WilliamWilson-1/H745_OSC-GEN/assets/branding/initui-source.jpg

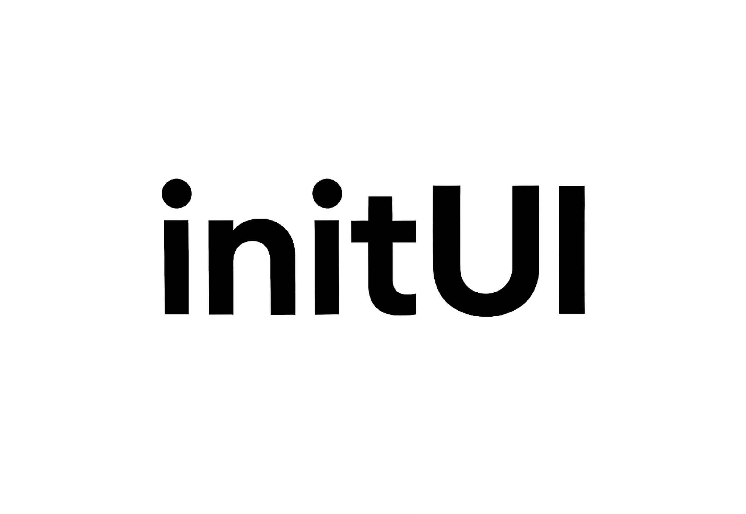
assets/branding/initui-source.jpg
