WilliamWilson-1/H745_OSC-GEN/docs/VALIDATION.md

# 固件验证记录（2026-09-15）

## v3.2 About / 主题增量（已刷写）

- 首页新增 About；显示原始 initUI 标志、William Wilson / Vida David / Dkkk、v3.2。
- 首页副标题改为 `Based on STM32H7`；About 顶栏不再显示 OSC / GEN。
- Graphite / Midnight / Ivory 三套主题覆盖四页，保留到复位；不更改仪器状态和输出，固定硬件调色板避免直接重着色当前扫描帧。
- H745 CM7、CM4、F103 三目标 Debug / Release 构建通过。CM7 Release：Flash 105,728 字节、DTCM 8,840 字节；原显存与 DMA 内存分区不变。
- 主机回归通过：四页 1,536,000 个按钮坐标；三套主题 × 四页渲染；主要文字配色对至少 4.5:1；重复切换、非法主题、调色板及待显示帧不变；已有缓冲、MDMA、拨钮、时基/粗微调、SINGLE/HOLD 与 99,951 个 DAC 频率设置测试。
- 已人工检查真实 C 渲染器生成的三种 About、首页、暖白示波器及发生器截图，无文字遮挡。截图波形是测试输入，不是设备实测。
- 已使用 ST-Link `002C00383331511434333834` 刷写 H745 CM4/CM7 Release，两核均读回校验成功并复位。F103 源码和通信协议未改变，本次未重复刷写 F103。
- 启动后 Hot Plug 只读检查：显示完成数从 366 增至 582，采集完成 583 帧，ADC/启动错误、FIFO 欠载、LTDC/MDMA 错误及超出消隐计数均为 0；最长复制 1053 us，预算 1422 us。最后读取为首页、DAC 关闭。这是短时启动检查，不代替物理触摸、主题切换和长期显示压力实测。
- 本次 CM7 Release ELF SHA-256：`C27B95792EB8364FF887B54878387B9B7242DB692BEABEDE504721AFC72600CB`；CM4 为 `F555630E9C6998F93C6CE584BCED17A4AAF6CEC866A00A100FD938B86CEDEEDF`。
- 以下分隔线之后的哈希、运行计数与实机结论保留为前一版记录。

---

## 本次功能

- 首页删除 01/02 编号；示波器卡片显示同一份真实 ADC trace，RUN 更新、HOLD 保持，无帧不伪造波形。
- 示波器右侧 Coarse/Fine 控制旋钮步进；标准档位与约 10% 微调相互切换，触发/垂直位置为 50 mV/10 mV。
- 同时包含此前的 2～20 us/div 快速时基、100 kHz 发生器设置上限、自适应 DAC 点数、仅右侧拨钮点击/拖动，以及消隐期 MDMA 刷新方案。
- 修复启动保护问题：本仓库 HAL 的 `HAL_RCCEx_GetPeriphCLKFreq()` 不支持 LTDC，改用 `HAL_RCCEx_GetPLL3ClockFreq()` 的 PLL3R 输出计算消隐预算。

## 构建与主机测试

H745 CM7、CM4、F103 的 Debug / Release 均构建通过。

`tools/preview_ui.py` 使用真实 C 源码和模拟 HAL 检查：

- 三页全部 1,152,000 个坐标的按钮命中、不重叠/越界及 48 px 最小高度。
- 连续/分段缓冲逐像素一致、边界保护、动效中断、减弱动效、时间回绕。
- 首页随输入改变，HOLD 不随时间自行改变，无数据提示，以及粗微调选中状态。
- 拨钮点击/拖动、中点保留、取消、页面离开、仅松手提交通断。
- 1000 次模拟消隐 MDMA 复制、延迟中断、重复提交及错误计数。
- 12 个标准时基、快速档 40/100/200/400 个真实点、双边沿、SINGLE、HOLD 旧帧失效。
- 微调中间值与标准档位的方向衔接、上下限、复位以及 10/50 mV 步进。
- 全部 99,951 个 50～100000 Hz 整数频率设置不超过 DAC 1 MHz 更新限制，100 kHz 名义定时分频准确，改表前停止 DMA。

可选 Windows AddressSanitizer 出现运行库拦截兼容警告，不将其列为完整通过的检查；普通主机测试断言全部通过。

## 刷写

使用明确的 ST-Link 序列号选择目标，Release 固件均写入并读回校验成功：

| 目标 | 实际识别 | 固件地址 |
| --- | --- | --- |
| H745 CM7 | NUCLEO-H745ZI-Q，设备 ID 0x450，Rev V，2 MiB Flash | 0x08000000 |
| H745 CM4 | 同一 H745 双核器件 | 0x08100000 |
| F103 | 设备 ID 0x410，64 KiB Flash，Cortex-M3 | 0x08000000 |

F103 继续采用实际板卡所需的晶振配置，未擅自改成 NUCLEO-F103RB 的 MCO 配置。PCB 接线表仍以用户指定的官方开发板排针为设计目标，见其适用条件说明。

已刷写 ELF 的 SHA-256（构建路径/工具链变化可能改变 ELF 的哈希）：

| 文件 | SHA-256 |
| --- | --- |
| NUCLEO_1_CM7.elf | `35B2F724A5A3B99DAB19A507CB84922F2F4626F9B6661DE67EE0AE8752467121` |
| NUCLEO_1_CM4.elf | `F555630E9C6998F93C6CE584BCED17A4AAF6CEC866A00A100FD938B86CEDEEDF` |
| stm32f103_hmi.elf | `EE93EC6496AD8E5174622ECBDA8CE07FF004FF7B1A429B071C98B3EEB79EBA76` |

## 实机运行检查

复位启动后，首页默认 RUN 可连续采集和提交画面。通过调试接口向 H745 触摸接收队列注入正常格式的测试消息，检查真实主循环处理路径；旋钮测试使用 TIM3 计数变化，不调用被测调整函数来绕过输入分发。

1. 进入示波器、连续双指缩放至 2 us/div，状态报告配置采样率 2,000,000 Hz。
2. 点击 Fine 后增加一个编码器计数，时基从 2 变为 3 us/div。
3. 点击 Coarse 后增加一个编码器计数，时基从 3 变为 5 us/div。
4. 点击 RUN/HOLD 再返回 Home：`running=0`、`frame_valid=1`，首页保持已有帧。两次独立读数之间采集和刷新计数保持不变。

在首页、快速时基连续采集与上述操作后读取的累计状态：

| 指标 | 结果 |
| --- | --- |
| 完成采集帧数 | 19,130 |
| 提交 / 完成显示帧数 | 5,109 / 5,109 |
| ADC 错误 / 启动失败 | 0 / 0 |
| LTDC FIFO 欠载 / 传输错误 | 0 / 0 |
| MDMA 错误 / 超出消隐次数 | 0 / 0 |
| 最近 / 最大整帧复制耗时 | 1053 / 1055 us |
| 消隐预算 | 1422 us |
| 发生器输出 | OFF，测试期间未开启 |

结束后复位回默认首页、500 us/div、粗调，DAC 输出关闭。

## 未覆盖的条件

这些结果不代替手指在实际屏幕上的手感确认，也不证明物理触摸 I2C/UART 全链路已完成所有异常测试。测试消息注入绕过了 F103 与触摸传感器。

本次未主动给外部电路开启 DAC 输出，因此未测量 100 kHz 输出的失真、满幅建立时间、实际频率精度，也未验证 ADC/DAC 同时工作时的总线压力。2 MS/s 为定时器配置值，未用外部基准独立校准。模拟输入带宽、接线负载、长时间运行、极端触摸压力和用户肉眼观察闪烁仍需要进一步实测。
