WilliamWilson-1/H745_OSC-GEN/CM7/Core/Src/main.c

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
/* Includes ------------------------------------------------------------------*/
#include "main.h"

/* USER CODE BEGIN Includes */
#include <math.h>  // 提供 sin() 函数支持
#include <stdlib.h> // 提供 abs() 函数支持
#include <stdio.h>
#include <stdarg.h>
#include <string.h>
#include "graph.h"
#include "display.h"
#include "generate.h"
#include "oscilloscope.h"
/* USER CODE END Includes */

/* USER CODE BEGIN PD */

/* DUAL_CORE_BOOT_SYNC_SEQUENCE: Define for dual core boot synchronization    */
/*                             demonstration code based on hardware semaphore */
/* This define is present in both CM7/CM4 projects                            */
/* To comment when developping/debugging on a single core                     */
// #define DUAL_CORE_BOOT_SYNC_SEQUENCE
//
// #if defined(DUAL_CORE_BOOT_SYNC_SEQUENCE)
// #ifndef HSEM_ID_0
// #define HSEM_ID_0 (0U) /* HW semaphore 0*/
// #endif
// #endif /* DUAL_CORE_BOOT_SYNC_SEQUENCE */

/* USER CODE END PD */


ADC_HandleTypeDef hadc1;
DMA_HandleTypeDef hdma_adc1;

DAC_HandleTypeDef hdac1;
DMA_HandleTypeDef hdma_dac1_ch2;

LTDC_HandleTypeDef hltdc;

TIM_HandleTypeDef htim3;
TIM_HandleTypeDef htim6;
TIM_HandleTypeDef htim2;

UART_HandleTypeDef huart1;

void SystemClock_Config(void);
static void MPU_Config(void);
static void MX_GPIO_Init(void);
static void MX_DMA_Init(void);
static void MX_ADC1_Init(void);
static void MX_LTDC_Init(void);
static void MX_TIM2_Init(void);
static void MX_TIM3_Init(void);
static void MX_USART1_UART_Init(void);
static void MX_DAC1_Init(void);
static void MX_TIM6_Init(void);
/* USER CODE BEGIN 0 */

// 💥 封装一个硬件同步中心：把 0~3.3V 转化为 0~2047 写入底层
void Sync_Hardware_WaveGen(void) {
    float hw_amp = (wg_amp / 3.3f) * 2047.0f;
    DAC_WaveGen_Configure(wg_wave, hw_amp, (uint32_t)wg_freq);
}

// 双指手势引擎内部变量
static uint16_t last_pinch_dist_x = 0;
static uint16_t last_pinch_dist_y = 0;
static uint8_t is_pinching = 0;

// 极客专属：格式化串口发送函数
void UART_SendToF103(const char *format, ...) {
    char tx_buf[64];
    va_list args;
    va_start(args, format);
    vsnprintf(tx_buf, sizeof(tx_buf), format, args);
    va_end(args);
    HAL_UART_Transmit(&huart1, (uint8_t*)tx_buf, strlen(tx_buf), 100);
}

// 触摸与重绘全局标志
volatile uint8_t global_needs_redraw = 0;
uint8_t h7_rx_byte;
static uint8_t touch_rx[256];
static volatile uint16_t touch_head, touch_tail;
static volatile uint8_t touch_overflow;
static void Poll_Touch_Input(void);

static void Reset_Current_Mode(void) {
    UI_OutputTouchCancel(HAL_GetTick());
    if (current_sys_state != SYS_OSC && current_sys_state != SYS_GEN) return;
    if (current_sys_state == SYS_OSC) {
        Oscilloscope_ResetControls();
        current_ctrl = CTRL_TIMEBASE;
    } else if (current_sys_state == SYS_GEN) {
        wg_freq = 1000.0f;
        wg_amp = 3.3f;
        wg_wave = WAVE_SINE;
        wg_ctrl = 0U;
        wg_enabled = 0U;
        DAC_WaveGen_SetEnabled(0U);
        Sync_Hardware_WaveGen();
        UART_SendToF103("F:1000\n");
        UART_SendToF103("A:3.3\n");
    }
    UI_NotifyReset(HAL_GetTick());
    global_needs_redraw = 1U;
}

// =========================================================
// 核心：带有“防抖与差分拦截”的触摸碰撞引擎
// =========================================================
void Process_Touch_Interaction(uint16_t x, uint16_t y) {
    UI_OutputTouchCancel(HAL_GetTick());
    global_needs_redraw = 1U;
    is_pinching = 0;
    UiAction action = UI_HitTest(current_sys_state, x, y);
    if (action == UI_NONE) return;
    UI_NotifyTouch(action, HAL_GetTick());
    switch (action) {
    case UI_HOME:
        /* Keep RUN live on Home; HOLD/SINGLE state remains authoritative. */
        current_sys_state = SYS_MAIN_MENU;
        UART_SendToF103("I:\n");
        break;
    case UI_OSC:
        main_menu_sel = 0;
        current_sys_state = SYS_OSC;
        break;
    case UI_GEN:
        main_menu_sel = 1;
        current_sys_state = SYS_GEN;
        UART_SendToF103("F:%d\n", (int)wg_freq);
        break;
    case UI_TIME: current_ctrl = CTRL_TIMEBASE; break;
    case UI_VOLTS: current_ctrl = CTRL_VOLTS_DIV; break;
    case UI_TRIGGER: current_ctrl = CTRL_TRIGGER_LEVEL; break;
    case UI_POSITION: current_ctrl = CTRL_VERTICAL_POS; break;
    case UI_RUN: Oscilloscope_ToggleRun(); break;
    case UI_SLOPE:
        Oscilloscope_SetTriggerSlope(Oscilloscope_GetState()->trigger_slope ==
            OSC_TRIGGER_RISING ? OSC_TRIGGER_FALLING : OSC_TRIGGER_RISING);
        break;
    case UI_SINGLE: Oscilloscope_Single(); break;
    case UI_COARSE: Oscilloscope_SetFineAdjustment(false); break;
    case UI_FINE: Oscilloscope_SetFineAdjustment(true); break;
    case UI_SINE: case UI_SQUARE: case UI_TRIANGLE:
        wg_wave = action == UI_SINE ? WAVE_SINE :
                  action == UI_SQUARE ? WAVE_SQUARE : WAVE_TRIANGLE;
        Sync_Hardware_WaveGen();
        break;
    case UI_OUTPUT:
        UI_OutputTouchDown(x, y, HAL_GetTick());
        break;
    case UI_FREQUENCY: wg_ctrl = 0U; break;
    case UI_AMPLITUDE: wg_ctrl = 1U; break;
    case UI_MOTION: UI_ToggleMotion(); break;
    case UI_ABOUT: current_sys_state = SYS_ABOUT; break;
    case UI_THEME_DARK: UI_SelectTheme(UI_THEME_GRAPHITE); break;
    case UI_THEME_BLUE: UI_SelectTheme(UI_THEME_MIDNIGHT); break;
    case UI_THEME_LIGHT: UI_SelectTheme(UI_THEME_IVORY); break;
    default: break;
    }
    global_needs_redraw = 1U;
}


// =========================================================
// 双指操作支持
// =========================================================


void Process_Pinch_Gesture(uint16_t x1, uint16_t y1, uint16_t x2, uint16_t y2) {
    // 只有在示波器模式下才允许缩放波形
    if (current_sys_state != SYS_OSC) return;

    // 计算当前双指在 X 轴和 Y 轴上的绝对距离
    uint16_t dist_x = abs((int)x1 - (int)x2);
    uint16_t dist_y = abs((int)y1 - (int)y2);

    if (!is_pinching) {
        // 第一帧双指按下，只记录初始距离，不触发形变
        last_pinch_dist_x = dist_x;
        last_pinch_dist_y = dist_y;
        is_pinching = 1;
        return;
    }

    // 计算相对于上一帧的位移增量 (这就是虚拟旋转编码器的 diff！)
    int16_t diff_x = (int16_t)dist_x - (int16_t)last_pinch_dist_x;
    int16_t diff_y = (int16_t)dist_y - (int16_t)last_pinch_dist_y;

    // 更新距离历史
    last_pinch_dist_x = dist_x;
    last_pinch_dist_y = dist_y;

    uint8_t state_changed = 0;

    // 💥 轴向手势分离逻辑
    // 判断用户的意图是水平捏合（调时基/频率）还是垂直捏合（调幅值）

    if (abs(diff_x) > abs(diff_y) && abs(diff_x) > 2) {
        // 阈值设为 2 防止手抖抖动
        // 水平捏合：切换采样时基。

        // 双指拉开：减小 time/div，让波形沿水平方向放大；捏合则缩小。
        Oscilloscope_AdjustTimebase(diff_x > 0 ? -1 : 1);
        state_changed = 1;
    }
    else if (abs(diff_y) > abs(diff_x) && abs(diff_y) > 2) {
        // 垂直捏合：切换垂直 V/div 档位。

        // 双指拉开 (diff_y > 0)，幅值变大；捏合变小
        Oscilloscope_AdjustVoltsPerDiv(diff_y > 0 ? -1 : 1);
        state_changed = 1;
    }

    if (state_changed) {
        global_needs_redraw = 1;
    }
}


/* USER CODE END 0 */

/**
  * @brief  The application entry point.
  * @retval int
  */
int main(void)
{

/* USER CODE BEGIN Boot_Mode_Sequence_0 */
#if defined(DUAL_CORE_BOOT_SYNC_SEQUENCE)
  int32_t timeout;
#endif /* DUAL_CORE_BOOT_SYNC_SEQUENCE */
/* USER CODE END Boot_Mode_Sequence_0 */

  /* MPU Configuration--------------------------------------------------------*/
  MPU_Config();

/* USER CODE BEGIN Boot_Mode_Sequence_1 */
#if defined(DUAL_CORE_BOOT_SYNC_SEQUENCE)
  /* Wait until CPU2 boots and enters in stop mode or timeout*/
  timeout = 0xFFFF;
  while((__HAL_RCC_GET_FLAG(RCC_FLAG_D2CKRDY) != RESET) && (timeout-- > 0));
  if ( timeout < 0 )
  {
  Error_Handler();
  }
#endif /* DUAL_CORE_BOOT_SYNC_SEQUENCE */
/* USER CODE END Boot_Mode_Sequence_1 */
  /* MCU Configuration--------------------------------------------------------*/

  /* Reset of all peripherals, Initializes the Flash interface and the Systick. */
  HAL_Init();

  /* Configure the system clock */
  SystemClock_Config();
/* USER CODE BEGIN Boot_Mode_Sequence_2 */
#if defined(DUAL_CORE_BOOT_SYNC_SEQUENCE)
/* When system initialization is finished, Cortex-M7 will release Cortex-M4 by means of
HSEM notification */
/*HW semaphore Clock enable*/
__HAL_RCC_HSEM_CLK_ENABLE();
/*Take HSEM */
HAL_HSEM_FastTake(HSEM_ID_0);
/*Release HSEM in order to notify the CPU2(CM4)*/
HAL_HSEM_Release(HSEM_ID_0,0);
/* wait until CPU2 wakes up from stop mode */
timeout = 0xFFFF;
while((__HAL_RCC_GET_FLAG(RCC_FLAG_D2CKRDY) == RESET) && (timeout-- > 0));
if ( timeout < 0 )
{
Error_Handler();
}
#endif /* DUAL_CORE_BOOT_SYNC_SEQUENCE */
/* USER CODE END Boot_Mode_Sequence_2 */

  /* Initialize all configured peripherals */
  MX_GPIO_Init();
  MX_DMA_Init();
  MX_ADC1_Init();
  MX_LTDC_Init();
  MX_TIM2_Init();
  MX_TIM3_Init();
  MX_USART1_UART_Init();
  MX_DAC1_Init();
  MX_TIM6_Init();
  /* USER CODE BEGIN 2 */

    UART_SendToF103("I:\n");

    // 装载默认波形参数；输出保持关闭，进入 GEN 后由 OUTPUT 按钮开启。
    Sync_Hardware_WaveGen();
    DAC_WaveGen_Init();

    UI_InitPalette();

    // 2. 启动编码器硬件解码！(TIM3)
    HAL_TIM_Encoder_Start(&htim3, TIM_CHANNEL_ALL);

    if (Oscilloscope_Init() != HAL_OK) {
        Error_Handler();
    }

    // Prepare a complete first frame before lighting the backlight.
    Display_Init();
    HAL_GPIO_WritePin(GPIOA, GPIO_PIN_7, GPIO_PIN_SET);


  /* USER CODE END 2 */

  /* Infinite loop */
  /* USER CODE BEGIN WHILE */

  // 别忘了在进入主循环前，开启串口接收中断，准备接收 F103 传来的触摸和手势数据
  HAL_UART_Receive_IT(&huart1, &h7_rx_byte, 1);

  int16_t last_encoder_cnt = (int16_t)__HAL_TIM_GET_COUNTER(&htim3);

  // Keep the initial ADC capture running for the Home live preview.
  Play_Cyber_Boot_Sequence();
  global_needs_redraw = 1U;

  while (1)
  {
      Poll_Touch_Input();
      // =========================================================
      // 编码器按键 (PE1)：无短按/长按复用，松开后只执行一次复位。
      // =========================================================
      static uint8_t encoder_btn_last = 1;
      static uint32_t btn_press_time = 0;

      uint8_t encoder_btn_now = HAL_GPIO_ReadPin(GPIOE, GPIO_PIN_1);

      // 只要处于低电平，就锁定旋钮防误触
      uint8_t is_button_pressing = (encoder_btn_now == GPIO_PIN_RESET);

      if (encoder_btn_last == 1 && encoder_btn_now == 0) {
          btn_press_time = HAL_GetTick();
      }

      if (encoder_btn_last == 0 && encoder_btn_now == 1) {
          if (HAL_GetTick() - btn_press_time >= 20U) {
              Reset_Current_Mode();
          }
      }

      encoder_btn_last = encoder_btn_now;

      // =========================================================
      // 唯一保留的物理输入：旋转编码器 (专职精细调参)
      // =========================================================
      int16_t current_cnt = (int16_t)__HAL_TIM_GET_COUNTER(&htim3);
      if (current_cnt != last_encoder_cnt) {
          int16_t diff = current_cnt - last_encoder_cnt;
          last_encoder_cnt = current_cnt;

          // 💥 只有在按键没被按下时，才允许响应旋转！(硬件与软件双重防误触)
          if (!is_button_pressing) {
              if (current_sys_state == SYS_OSC) {
                  UART_SendToF103("I:\n"); // 打断 F103 跑马灯
                  int16_t step = diff > 0 ? 1 : -1;
                  bool fine = Oscilloscope_GetState()->fine_adjustment;
                  switch (current_ctrl) {
                      case CTRL_TIMEBASE:
                          if (fine) Oscilloscope_AdjustTimebaseFine(step);
                          else Oscilloscope_AdjustTimebase(step);
                          break;
                      case CTRL_VOLTS_DIV:
                          if (fine) Oscilloscope_AdjustVoltsPerDivFine(step);
                          else Oscilloscope_AdjustVoltsPerDiv(step);
                          break;
                      case CTRL_TRIGGER_LEVEL:
                          if (fine) Oscilloscope_AdjustTriggerFine(-step);
                          else Oscilloscope_AdjustTrigger(-step);
                          break;
                      case CTRL_VERTICAL_POS:
                          if (fine) Oscilloscope_AdjustVerticalPositionFine(-step);
                          else Oscilloscope_AdjustVerticalPosition(-step);
                          break;
                  }
                  global_needs_redraw = 1;
              }
              else if (current_sys_state == SYS_GEN) {
                  if (wg_ctrl == 0) {
                      float step;

                      // 💥 核心逻辑：根据当前频率所在的区间，动态分配旋钮步长
                      if (wg_freq >= 10000.0f) {
                          step = 500.0f; // 大于等于 10k 时，步进 1kHz
                      } else if (wg_freq >= 1000.0f) {
                          step = 50.0f;  // 大于等于 1k 且小于 10k 时，步进 0.1kHz (100Hz)
                      } else {
                          step = 5.0f;    // 小于 1k 时，精细步进 5Hz
                      }

                      // 应用动态步长 (注意这里保留了你原来的 -= 逻辑，如果旋钮方向反了改成 += 即可)
                      wg_freq -= diff * step;

                      // 硬件物理极限防呆保护
                      if(wg_freq < 50.0f) wg_freq = 50.0f;
                      if(wg_freq > 100000.0f) wg_freq = 100000.0f;

                      UART_SendToF103("F:%d\n", (int)wg_freq); // 同步给 F103 VFD 屏幕
                  } else {
                      wg_amp -= diff * 0.05f;
                      if(wg_amp < 0.0f) wg_amp = 0.0f;
                      if(wg_amp > 3.3f) wg_amp = 3.3f;
                      int a_int = (int)wg_amp;
                      int a_frac = (int)((wg_amp - a_int) * 10);
                      UART_SendToF103("A:%d.%d\n", a_int, a_frac); // 同步给 F103
                  }

                  Sync_Hardware_WaveGen(); // 💥 旋钮调参完成，即时同步底层 DAC！

                  global_needs_redraw = 1;
              }
          }
      }

      // =========================================================
      // 统一渲染调度 (被触摸、手势或编码器触发)
      // =========================================================
      static uint32_t last_render = 0U;
      if (Oscilloscope_Poll() && (current_sys_state == SYS_OSC || current_sys_state == SYS_MAIN_MENU)) {
          global_needs_redraw = 1U;
      }
      uint32_t now = HAL_GetTick();
      if (UI_Tick(now)) global_needs_redraw = 1U;

      if (global_needs_redraw && now - last_render >= 33U && Display_BeginFrame()) {
          last_render = now;
          global_needs_redraw = 0; // 清除标志
          UI_Render();

          Display_Present();
      }

      HAL_Delay(1); // 动效按时间推进，输入处理不等待动效结束。
    /* USER CODE END WHILE */

    /* USER CODE BEGIN 3 */
  }
  /* USER CODE END 3 */
}

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
/* USER CODE BEGIN 4 */
void HAL_ADC_ConvCpltCallback(ADC_HandleTypeDef *hadc)
{
    Oscilloscope_OnConversionComplete(hadc);
}

void HAL_ADC_ErrorCallback(ADC_HandleTypeDef *hadc)
{
    Oscilloscope_OnError(hadc);
}

void HAL_UART_RxCpltCallback(UART_HandleTypeDef *huart) {
    if (huart->Instance == USART1) {
        uint16_t next = (touch_head + 1U) & 255U;
        if (next != touch_tail) {
            touch_rx[touch_head] = h7_rx_byte;
            __DMB();
            touch_head = next;
        } else {
            touch_overflow = 1U;
        }
        // ISR only receives bytes. Parsing, drawing and ADC/DAC changes run in main.
        HAL_UART_Receive_IT(&huart1, &h7_rx_byte, 1);
    }
}

void HAL_UART_ErrorCallback(UART_HandleTypeDef *huart) {
    if (huart->Instance == USART1) {
        touch_overflow = 1U;
        HAL_UART_Receive_IT(&huart1, &h7_rx_byte, 1);
    }
}

static void Poll_Touch_Input(void) {
    static char command[32];
    static uint8_t length, discard;
    if (touch_overflow) {
        uint32_t primask = __get_PRIMASK();
        __disable_irq();
        touch_tail = touch_head;
        touch_overflow = 0U;
        __set_PRIMASK(primask);
        length = 0U;
        discard = 1U;
        is_pinching = 0U;
        UI_OutputTouchCancel(HAL_GetTick());
        global_needs_redraw = 1U;
    }
    // Bound each pass so malformed/continuous input cannot starve acquisition.
    for (unsigned budget = 0; budget < 256U && touch_tail != touch_head; ++budget) {
        __DMB();
        uint8_t byte = touch_rx[touch_tail];
        __DMB();
        touch_tail = (touch_tail + 1U) & 255U;
        if (byte == '\r') continue;
        if (byte != '\n') {
            if (!discard && length < sizeof(command) - 1U) command[length++] = byte;
            else discard = 1U;
            continue;
        }
        command[length] = '\0';
        if (!discard) {
            int x1, y1, x2, y2;
            char extra;
            if (sscanf(command, "T:%4d,%4d%c", &x1, &y1, &extra) == 2 &&
                x1 >= 0 && x1 < 800 && y1 >= 0 && y1 < 480) {
                Process_Touch_Interaction((uint16_t)x1, (uint16_t)y1);
            } else if (sscanf(command, "D:%4d,%4d%c", &x1, &y1, &extra) == 2 &&
                x1 >= 0 && x1 < 800 && y1 >= 0 && y1 < 480) {
                if (UI_OutputTouchMove((uint16_t)x1, (uint16_t)y1, HAL_GetTick())) {
                    global_needs_redraw = 1U;
                }
            } else if (sscanf(command, "M:%4d,%4d,%4d,%4d%c", &x1, &y1, &x2, &y2, &extra) == 4 &&
                x1 >= 0 && x1 < 800 && y1 >= 0 && y1 < 480 &&
                x2 >= 0 && x2 < 800 && y2 >= 0 && y2 < 480) {
                UI_OutputTouchCancel(HAL_GetTick());
                global_needs_redraw = 1U;
                Process_Pinch_Gesture((uint16_t)x1, (uint16_t)y1, (uint16_t)x2, (uint16_t)y2);
            } else if (strcmp(command, "C:") == 0) {
                UI_OutputTouchCancel(HAL_GetTick());
                is_pinching = 0U;
                global_needs_redraw = 1U;
            } else if (strcmp(command, "U:") == 0) {
                is_pinching = 0U;
                if (UI_OutputTouchRelease(HAL_GetTick())) {
                    DAC_WaveGen_SetEnabled(wg_enabled);
                }
                global_needs_redraw = 1U;
            } else {
                UI_OutputTouchCancel(HAL_GetTick());
                global_needs_redraw = 1U;
            }
        } else {
            UI_OutputTouchCancel(HAL_GetTick());
            global_needs_redraw = 1U;
        }
        length = 0U;
        discard = 0U;
    }
}


/* USER CODE END 4 */

 /* MPU Configuration */

void MPU_Config(void)
{
  MPU_Region_InitTypeDef MPU_InitStruct = {0};

  /* Disables the MPU */
  HAL_MPU_Disable();

  /** Initializes and configures the Region and the memory to be protected
  */
  MPU_InitStruct.Enable = MPU_REGION_ENABLE;
  MPU_InitStruct.Number = MPU_REGION_NUMBER0;
  MPU_InitStruct.BaseAddress = 0x0;
  MPU_InitStruct.Size = MPU_REGION_SIZE_4GB;
  MPU_InitStruct.SubRegionDisable = 0x87;
  MPU_InitStruct.TypeExtField = MPU_TEX_LEVEL0;
  MPU_InitStruct.AccessPermission = MPU_REGION_NO_ACCESS;
  MPU_InitStruct.DisableExec = MPU_INSTRUCTION_ACCESS_DISABLE;
  MPU_InitStruct.IsShareable = MPU_ACCESS_SHAREABLE;
  MPU_InitStruct.IsCacheable = MPU_ACCESS_NOT_CACHEABLE;
  MPU_InitStruct.IsBufferable = MPU_ACCESS_NOT_BUFFERABLE;

  HAL_MPU_ConfigRegion(&MPU_InitStruct);
  /* Enables the MPU */
  HAL_MPU_Enable(MPU_PRIVILEGED_DEFAULT);

}

/**
  * @brief  This function is executed in case of error occurrence.
  * @retval None
  */
void Error_Handler(void)
{
  /* USER CODE BEGIN Error_Handler_Debug */
  /* User can add his own implementation to report the HAL error return state */
  __disable_irq();
  while (1)
  {
  }
  /* USER CODE END Error_Handler_Debug */
}
#ifdef USE_FULL_ASSERT
/**
  * @brief  Reports the name of the source file and the source line number
  *         where the assert_param error has occurred.
  * @param  file: pointer to the source file name
  * @param  line: assert_param error line source number
  * @retval None
  */
void assert_failed(uint8_t *file, uint32_t line)
{
  /* USER CODE BEGIN 6 */
  /* User can add his own implementation to report the file name and line number,
     ex: printf("Wrong parameters value: file %s on line %d\r\n", file, line) */
  /* USER CODE END 6 */
}
#endif /* USE_FULL_ASSERT */
