WilliamWilson-1/H745_OSC-GEN/NUCLEO_1.ioc

Mcu.UserName=STM32H745ZITx
PA1.Signal=LTDC_R2
PA10.Signal=LTDC_B1
PA11.Signal=LTDC_R4
PA2.Signal=LTDC_R1
PA3.Signal=LTDC_B5
PA4.Signal=LTDC_VSYNC
PA5.Signal=COMP_DAC12_group
PA6.Signal=LTDC_G2
PA7.Signal=GPIO_Output
PB0.Signal=LTDC_R3
PB1.Signal=LTDC_R6
PB10.Signal=LTDC_G4
PB11.Signal=LTDC_G5
PB14.Signal=USART1_TX
PB15.Signal=USART1_RX
PB5.Signal=S_TIM3_CH2
PB8.Signal=LTDC_B6
PB9.Signal=LTDC_B7
PC0.Signal=LTDC_R5
PC4.Signal=GPIO_Output
PC5.Signal=GPIO_Output
PC6.Signal=LTDC_HSYNC
PC7.Signal=LTDC_G6
PC9.Signal=LTDC_B2
PD10.Signal=LTDC_B3
PD8.GPIO_Label=STLINK_RX
PD8.Signal=USART3_TX
PD9.GPIO_Label=STLINK_TX
PD9.Signal=USART3_RX
PE1.Signal=GPIO_Input
PE11.Signal=LTDC_G3
PE12.Signal=LTDC_B4
PE14.Signal=LTDC_CLK
PE15.Signal=LTDC_R7
PE4.Signal=LTDC_B0
PE5.Signal=LTDC_G0
PE6.Signal=LTDC_G1
PF10.Signal=LTDC_DE
PF11.Signal=ADC1_INP2
PG13.Signal=LTDC_R0
PG8.Signal=LTDC_G7
